2026-PNU-CSE-GRAD-RFVisualizer/Embedded/rssi_esp32_to_stm32/stm32_receiver/README.md

# STM32 Receiver Module

This folder contains board-portable C modules for the STM32 side.

Files:

- `rssi_line_parser.*`: byte stream and line parser for `$RSSI` messages.
- `rssi_preprocessor.*`: node table, timeout tracking, sequence loss tracking.
- `mqtt_payload.*`: MQTT-ready JSON payload formatter.
- `stm32_uart_receiver_example.c`: HAL UART interrupt integration example.
- `test_parser_host.c`: PC host test.

The parser and preprocessor use no dynamic allocation. Packet/UART protocol version 2
preserves the originating node's Unix epoch measurement time in
`readings[].timestamp`; a zero timestamp is invalid and is accompanied by
`RSSI_ERR_TIME_INVALID`.

## Integration Steps

1. Add `rssi_line_parser.c`, `rssi_preprocessor.c`, and `mqtt_payload.c` to the STM32CubeIDE project.
2. Include the corresponding headers.
3. In the UART RX interrupt callback, feed each byte to `rssi_parser_feed_byte()`.
4. On `RSSI_PARSE_OK`, call `rssi_preprocessor_update()`.
5. Periodically call `mqtt_payload_build_snapshot()`, passing monotonic uptime for
   timeout calculations and Unix epoch milliseconds for snapshot creation time,
   then publish the resulting string through the selected MQTT/network module.

The included MQTT formatter only builds the payload string; it does not depend on any MQTT client library.
