2026-PNU-CSE-GRAD-RFVisualizer/Embedded/handheld_jpeg_stream/captured_rfjf_frame.bmp

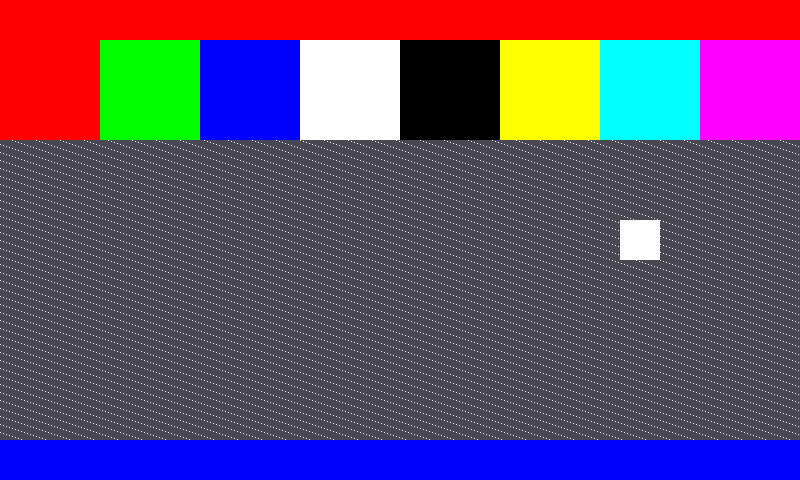
handheld_jpeg_stream/captured_rfjf_frame.bmp
