2026-PNU-CSE-GRAD-RFVisualizer/Embedded/handheld_bno085_test/components/ceva_sh2/VERSION.txt

Upstream: https://github.com/ceva-dsp/sh2
Commit: b514b1e2586ddc195e553dac89fc94c637b25298
License: Apache-2.0 (see NOTICE.txt and source headers)
