2026-PNU-CSE-GRAD-RFVisualizer/Embedded/HANDHELD_BUTTON_WIRING.md

# 폐기됨: Handheld 버튼 단독 배선 문서

이 문서의 이전 버전은 버튼만 대상으로 빨간 선을 신호선으로 지정했으므로 사용하지 않는다.

ESP32-S3, LCD, BNO085, 버튼을 모두 포함하고 전선 색상을 안전하게 통일한 최신 문서는 다음 파일이다.

- [HANDHELD_COMPLETE_WIRING.md](./HANDHELD_COMPLETE_WIRING.md)

최신 기준:

- 검정: GND
- 빨강: 전원(반드시 `5V` 또는 `3V3` 라벨 부착)
- 파랑: 신호(반드시 신호명 라벨 부착)
