2026-PNU-CSE-GRAD-RFVisualizer/Embedded/handheld_jpeg_stream/main/test_animation/frames/frame_03.jpg

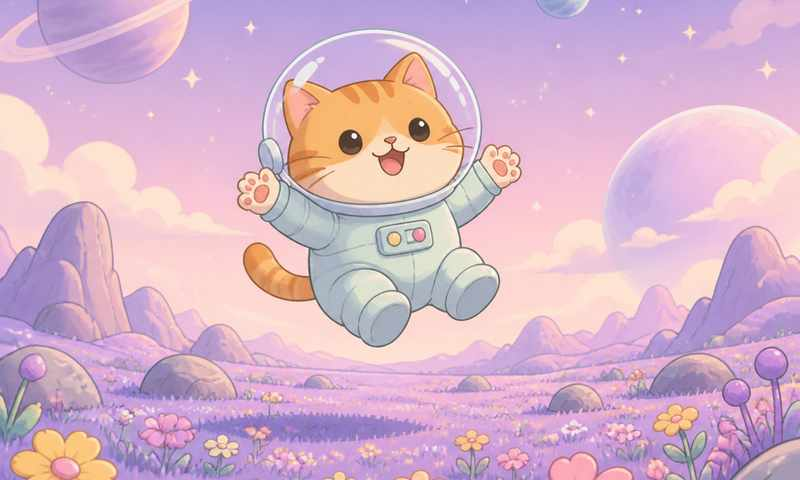
handheld_jpeg_stream/main/test_animation/frames/frame_03.jpg
