2026-PNU-CSE-GRAD-RFVisualizer/Embedded/handheld_jpeg_stream/main/app_main.c

#include <stdbool.h>
#include <string.h>

#include "esp_event.h"
#include "esp_log.h"
#include "esp_timer.h"
#include "esp_netif.h"
#include "esp_wifi.h"
#include "freertos/FreeRTOS.h"
#include "freertos/event_groups.h"
#include "freertos/task.h"
#include "nvs_flash.h"

#include "lcd_board_config.h"
#include "lcd_gpio_writer.h"
#include "jpeg_lcd_sink.h"
#include "jpeg_stream_client.h"
#include "jpeg_stream_protocol.h"
#include "rgb332_zlib_sink.h"
#include "handheld_control_udp.h"
#if CONFIG_HANDHELD_LOCAL_BNO085_LCD_TEST || CONFIG_HANDHELD_CONTROL_UDP || CONFIG_HANDHELD_BNO085_SERVICE
#include "bno085_local_test.h"
#endif
#if CONFIG_HANDHELD_LOCAL_10FPS_TEST
#if CONFIG_HANDHELD_LOCAL_3D_TEST
#include "local_3d_test.h"
#else
#include "local_animation_test.h"
#endif
#endif

#define WIFI_CONNECTED_BIT BIT0

static const char *TAG = "handheld_jpeg";
static EventGroupHandle_t s_wifi_events;

#if 0  /* Disabled: boot RGB test can be confused with server frames. */
static inline uint16_t rgb565(uint8_t red, uint8_t green, uint8_t blue)
{
    return ((uint16_t)(red & 0xF8) << 8) |
           ((uint16_t)(green & 0xFC) << 3) |
           ((uint16_t)blue >> 3);
}

static void show_boot_color_test(void)
{
    static const struct {
        const char *name;
        uint16_t color;
    } colors[] = {
        {"RED",   0xF800},
        {"GREEN", 0x07E0},
        {"BLUE",  0x001F},
    };

    for (size_t i = 0; i < sizeof(colors) / sizeof(colors[0]); ++i) {
        ESP_LOGI(TAG, "boot LCD color test: %s", colors[i].name);
        lcd_gpio_writer_fill(colors[i].color);
        vTaskDelay(pdMS_TO_TICKS(500));
    }

    lcd_gpio_writer_fill(rgb565(0, 0, 0));
    ESP_LOGI(TAG, "boot LCD color test complete");
}
#endif

static void wifi_event_handler(void *argument, esp_event_base_t event_base,
                               int32_t event_id, void *event_data)
{
    (void)argument;
    (void)event_data;
    if (event_base == WIFI_EVENT && event_id == WIFI_EVENT_STA_START) {
        esp_wifi_connect();
    } else if (event_base == WIFI_EVENT && event_id == WIFI_EVENT_STA_DISCONNECTED) {
        xEventGroupClearBits(s_wifi_events, WIFI_CONNECTED_BIT);
        ESP_LOGW(TAG, "Wi-Fi disconnected; reconnecting");
        esp_wifi_connect();
    } else if (event_base == IP_EVENT && event_id == IP_EVENT_STA_GOT_IP) {
        xEventGroupSetBits(s_wifi_events, WIFI_CONNECTED_BIT);
    }
}

static void wifi_start(void)
{
    ESP_ERROR_CHECK(esp_netif_init());
    ESP_ERROR_CHECK(esp_event_loop_create_default());
    esp_netif_create_default_wifi_sta();

    const wifi_init_config_t init_config = WIFI_INIT_CONFIG_DEFAULT();
    ESP_ERROR_CHECK(esp_wifi_init(&init_config));
    ESP_ERROR_CHECK(esp_event_handler_register(WIFI_EVENT, ESP_EVENT_ANY_ID,
                                               wifi_event_handler, NULL));
    ESP_ERROR_CHECK(esp_event_handler_register(IP_EVENT, IP_EVENT_STA_GOT_IP,
                                               wifi_event_handler, NULL));

    wifi_config_t wifi_config = {0};
    strlcpy((char *)wifi_config.sta.ssid, CONFIG_HANDHELD_WIFI_SSID,
            sizeof(wifi_config.sta.ssid));
    strlcpy((char *)wifi_config.sta.password, CONFIG_HANDHELD_WIFI_PASSWORD,
            sizeof(wifi_config.sta.password));
    wifi_config.sta.threshold.authmode = strlen(CONFIG_HANDHELD_WIFI_PASSWORD) > 0
        ? WIFI_AUTH_WPA2_PSK : WIFI_AUTH_OPEN;

    ESP_ERROR_CHECK(esp_wifi_set_mode(WIFI_MODE_STA));
    ESP_ERROR_CHECK(esp_wifi_set_config(WIFI_IF_STA, &wifi_config));
    ESP_ERROR_CHECK(esp_wifi_start());
    /* A DTIM/listen interval of three batches the 10 FPS TCP stream into
     * roughly 300 ms bursts. Keep the Handheld awake for even frame pacing. */
    ESP_ERROR_CHECK(esp_wifi_set_ps(WIFI_PS_NONE));
    ESP_LOGI(TAG, "Wi-Fi power save disabled for low-latency image streaming");
}

static void on_jpeg_frame(const jpeg_stream_frame_t *frame, void *user_context)
{
    (void)user_context;
    static int64_t window_start;
    static uint32_t displayed, failed;
    static jpeg_stream_client_stats_t previous;
    const int64_t started = esp_timer_get_time();
    if (!window_start) window_start = started;
    esp_err_t result;
    if (frame->flags == JPEG_STREAM_FLAG_RGB332_ZLIB ||
        frame->flags == JPEG_STREAM_FLAG_PALETTE256_ZLIB) {
        result = rgb332_zlib_sink_render(frame);
    } else {
        result = jpeg_lcd_sink_render(frame);
    }
    if (result == ESP_OK) ++displayed;
    else ++failed;
    const int64_t now = esp_timer_get_time();
    if (now - window_start >= 1000000) {
        jpeg_stream_client_stats_t current;
        jpeg_stream_client_get_stats(&current);
        const double seconds = (now - window_start) / 1000000.0;
        ESP_LOGI(TAG, "stream rx_fps=%.2f display_fps=%.2f stale=%lu gaps=%lu failed=%lu",
                 (current.frames_received - previous.frames_received) / seconds,
                 displayed / seconds,
                 (unsigned long)(current.stale_frames_dropped - previous.stale_frames_dropped),
                 (unsigned long)(current.sequence_gaps - previous.sequence_gaps),
                 (unsigned long)failed);
        previous = current;
        displayed = failed = 0;
        window_start = now;
    }
    if (result != ESP_OK) {
        ESP_LOGW(TAG, "frame seq=%lu was not displayed: %s",
                 (unsigned long)frame->seq, esp_err_to_name(result));
    }
}

void app_main(void)
{
    esp_err_t nvs_result = nvs_flash_init();
    if (nvs_result == ESP_ERR_NVS_NO_FREE_PAGES ||
        nvs_result == ESP_ERR_NVS_NEW_VERSION_FOUND) {
        ESP_ERROR_CHECK(nvs_flash_erase());
        nvs_result = nvs_flash_init();
    }
    ESP_ERROR_CHECK(nvs_result);

#if CONFIG_HANDHELD_LOCAL_10FPS_TEST || CONFIG_HANDHELD_RGB565_BENCHMARK
    const bool lcd_enabled = true;
#else
    const bool lcd_enabled = CONFIG_JPEG_STREAM_SERVER_HOST[0] != '\0';
#endif
    if (lcd_enabled) {
        ESP_ERROR_CHECK(jpeg_lcd_sink_init());
    } else {
        ESP_LOGI(TAG, "control-only mode: LCD/JPEG buffers are not allocated");
    }
    // show_boot_color_test();  // Disabled while testing server RGB332 frames.

#if CONFIG_HANDHELD_LOCAL_BNO085_LCD_TEST || CONFIG_HANDHELD_CONTROL_UDP || CONFIG_HANDHELD_BNO085_SERVICE
    ESP_ERROR_CHECK(bno085_local_test_start());
    if (lcd_enabled) {
        lcd_gpio_writer_set_transfer_gate(bno085_local_test_lcd_begin,
                                          bno085_local_test_lcd_end);
        ESP_LOGI(TAG, "BNO085 service and LCD I/O gate started");
    } else {
        ESP_LOGI(TAG, "BNO085 service started without LCD I/O");
    }
#endif

#if CONFIG_HANDHELD_RGB565_BENCHMARK
    jpeg_lcd_sink_benchmark();
#endif

#if CONFIG_HANDHELD_LOCAL_10FPS_TEST
    ESP_LOGI(TAG, "local 10 FPS animation test enabled; Wi-Fi is skipped");
#if CONFIG_HANDHELD_LOCAL_3D_TEST
    local_3d_test_run();
#else
    local_animation_test_run();
#endif
#endif

    if (CONFIG_HANDHELD_WIFI_SSID[0] == '\0') {
        ESP_LOGE(TAG, "set Wi-Fi with: idf.py menuconfig");
        return;
    }
#if CONFIG_HANDHELD_CONTROL_UDP
    if (CONFIG_HANDHELD_CONTROL_BACKEND_HOST[0] == '\0') {
        ESP_LOGE(TAG, "set Handheld Control Backend/proxy host with: idf.py menuconfig");
        return;
    }
#else
    if (CONFIG_JPEG_STREAM_SERVER_HOST[0] == '\0') {
        ESP_LOGE(TAG, "set image relay host with: idf.py menuconfig");
        return;
    }
#endif

    s_wifi_events = xEventGroupCreate();
    ESP_ERROR_CHECK(s_wifi_events == NULL ? ESP_ERR_NO_MEM : ESP_OK);
    wifi_start();
    ESP_LOGI(TAG, "waiting for Wi-Fi");
    xEventGroupWaitBits(s_wifi_events, WIFI_CONNECTED_BIT, pdFALSE, pdTRUE,
                        portMAX_DELAY);

#if CONFIG_HANDHELD_CONTROL_UDP
    const handheld_control_udp_config_t control_config = {
        .backend_host = CONFIG_HANDHELD_CONTROL_BACKEND_HOST,
        .backend_port = CONFIG_HANDHELD_CONTROL_BACKEND_PORT,
        .device_id = CONFIG_HANDHELD_CONTROL_DEVICE_ID,
    };
    ESP_ERROR_CHECK(handheld_control_udp_start(&control_config));
    ESP_LOGI(TAG, "Handheld Control UDP started");
#endif

    if (CONFIG_JPEG_STREAM_SERVER_HOST[0] != '\0') {
        const jpeg_stream_client_config_t client_config = {
            .server_host = CONFIG_JPEG_STREAM_SERVER_HOST,
            .server_port = CONFIG_JPEG_STREAM_SERVER_PORT,
            .max_frame_bytes = CONFIG_JPEG_STREAM_MAX_FRAME_BYTES,
            .receive_timeout_ms = CONFIG_JPEG_STREAM_RX_TIMEOUT_MS,
            .reconnect_initial_ms = 1000,
            .reconnect_max_ms = 10000,
            .on_frame = on_jpeg_frame,
            .user_context = NULL,
        };
        ESP_ERROR_CHECK(jpeg_stream_client_start(&client_config));
        ESP_LOGI(TAG, "JPEG stream client started");
    } else {
        ESP_LOGI(TAG, "JPEG stream disabled: no relay host configured");
    }
}
