2026-PNU-CSE-GRAD-RFVisualizer/Embedded/stm32_serial_mqtt_bridge.py

import argparse
import json
import sys
import time
import traceback
from pathlib import Path

from paho.mqtt import MQTTException
import paho.mqtt.client as mqtt

try:
    import serial
except ImportError:
    print("pyserial is required: python -m pip install pyserial")
    raise


DEFAULT_SERVER_IP = "192.168.0.4"
DEFAULT_PORT = 1883
DEFAULT_SERIAL_PORT = "COM4"
DEFAULT_BAUDRATE = 115200
DEFAULT_GATEWAY_ID = "gw-01"
DEFAULT_PUBLISH_MODE = "individual"
DEFAULT_AP_CHANNEL = 6
DEFAULT_POSITIONS_FILE = Path(__file__).with_name("node_positions.json")
SCHEMA_VERSION = 2
RSSI_VALID_MIN_DBM = -110
RSSI_VALID_MAX_DBM = -10
PUBLISH_TIMEOUT_SEC = 5.0
PUBLISH_RETRY_COUNT = 3
RECONNECT_DELAY_SEC = 2.0
HEARTBEAT_INTERVAL_SEC = 2.0


def parse_args():
    parser = argparse.ArgumentParser(
        description="Read STM32 gateway JSON lines from UART and publish them to MQTT."
    )
    parser.add_argument("--server", default=DEFAULT_SERVER_IP)
    parser.add_argument("--port", type=int, default=DEFAULT_PORT)
    parser.add_argument("--serial-port", default=DEFAULT_SERIAL_PORT)
    parser.add_argument("--baudrate", type=int, default=DEFAULT_BAUDRATE)
    parser.add_argument("--gateway-id", default=DEFAULT_GATEWAY_ID)
    parser.add_argument(
        "--ap-channel",
        type=int,
        choices=range(1, 15),
        default=DEFAULT_AP_CHANNEL,
    )
    parser.add_argument("--client-id", default="stm32-serial-gw-01")
    parser.add_argument("--topic", default=None)
    parser.add_argument("--positions-file", default=str(DEFAULT_POSITIONS_FILE))
    parser.add_argument(
        "--publish-mode",
        choices=("individual", "gateway", "both"),
        default=DEFAULT_PUBLISH_MODE,
        help="individual publishes rssi/<node_id>; gateway publishes one batch",
    )
    return parser.parse_args()


def now_ms():
    return int(time.time() * 1000)


def node_name(node_id):
    try:
        numeric = int(node_id)
    except (TypeError, ValueError):
        return str(node_id)

    if numeric == 5:
        return "gw-01"

    return f"node-{numeric:02d}"


def filtered_dbm_from_x10(value):
    value = int(value)
    if value >= 0:
        return int((value + 5) / 10)
    return int((value - 5) / 10)


def publish_checked(client, topic, payload, qos=1, retain=False, retries=PUBLISH_RETRY_COUNT):
    text = json.dumps(payload, separators=(",", ":"))
    last_error = "unknown error"

    for attempt in range(1, retries + 1):
        info = client.publish(topic, text, qos=qos, retain=retain)
        if info.rc != mqtt.MQTT_ERR_SUCCESS:
            last_error = f"rc={info.rc}"
        else:
            try:
                info.wait_for_publish(timeout=PUBLISH_TIMEOUT_SEC)
                if info.is_published():
                    return text
                last_error = f"PUBACK timeout after {PUBLISH_TIMEOUT_SEC:.0f}s"
            except RuntimeError as exc:
                last_error = str(exc)

        if attempt < retries:
            print(f"publish retry {attempt}/{retries} topic={topic}: {last_error}")
            time.sleep(1.0)

    raise RuntimeError(f"publish failed topic={topic}: {last_error}")


def status_payload(gateway_id, online):
    return {
        "node_id": gateway_id,
        "online": online,
        "timestamp": now_ms(),
    }


def load_node_positions(path):
    with open(path, "r", encoding="utf-8") as file:
        raw_positions = json.load(file)

    if not isinstance(raw_positions, dict):
        raise ValueError("positions file must contain a JSON object")

    positions = {}
    for node_id, position in raw_positions.items():
        if not isinstance(position, dict):
            raise ValueError(f"invalid position for {node_id}")

        positions[str(node_id)] = {
            "pos_x": float(position["pos_x"]),
            "pos_y": float(position["pos_y"]),
            "pos_z": float(position["pos_z"]),
        }

    return positions


def attach_position(reading, positions, ap_channel=DEFAULT_AP_CHANNEL):
    node_id = reading["node_id"]
    position = positions.get(node_id)
    positioned = {
        "node_id": node_id,
        "timestamp": reading["timestamp"],
        "rssi": reading["rssi"],
        "seq": reading["seq"],
        "ap_channel": ap_channel,
    }

    if position is not None:
        positioned.update(position)

    if "ap_bssid" in reading:
        positioned["ap_bssid"] = reading["ap_bssid"]
    if "rssi_raw" in reading:
        positioned["rssi_raw"] = reading["rssi_raw"]

    positioned["status"] = reading["status"]
    return positioned, position is not None


def normalize_reading(item, batch_timestamp, require_node_timestamp=False):
    node_id = node_name(item["node_id"])
    timestamp_value = item.get("timestamp", item.get("node_ts"))
    if timestamp_value is None:
        if require_node_timestamp:
            raise ValueError(f"{node_id} reading is missing timestamp")
        timestamp_value = batch_timestamp

    timestamp = int(timestamp_value)
    rssi = int(item["rssi"])
    if not RSSI_VALID_MIN_DBM <= rssi <= RSSI_VALID_MAX_DBM:
        return None

    reading = {
        "node_id": node_id,
        "timestamp": timestamp,
        "rssi": rssi,
        "seq": int(item.get("seq", 0)),
        "status": int(item.get("status", item.get("error_flags", 0))),
    }

    if "rssi_raw" in item:
        reading["rssi_raw"] = int(item["rssi_raw"])
    elif "rssi_raw_dbm" in item:
        reading["rssi_raw"] = int(item["rssi_raw_dbm"])

    if item.get("ap_bssid"):
        reading["ap_bssid"] = str(item["ap_bssid"])

    return reading


def normalize_gateway_payload(raw_payload, gateway_id):
    received_timestamp = now_ms()

    if "readings" in raw_payload:
        schema_version = int(raw_payload.get("schema_version", SCHEMA_VERSION))
        if schema_version != SCHEMA_VERSION:
            raise ValueError(f"unsupported schema_version: {schema_version}")

        timestamp = int(raw_payload.get("timestamp", received_timestamp))
        readings = raw_payload.get("readings") or []
        normalized_readings = []
        for item in readings:
            if "node_id" not in item or "rssi" not in item:
                continue

            reading = normalize_reading(
                item,
                timestamp,
                require_node_timestamp=True,
            )
            if reading is not None:
                normalized_readings.append(reading)

        return {
            "schema_version": SCHEMA_VERSION,
            "gateway_id": raw_payload.get("gateway_id", gateway_id),
            "timestamp": timestamp,
            "readings": normalized_readings,
        }

    # Compatibility with the older STM32 payload:
    # {"device_id":...,"nodes":[{"node_id":5,"rssi_filtered_x10":-598,...}]}
    if "nodes" in raw_payload:
        timestamp = received_timestamp
        readings = []
        for item in raw_payload.get("nodes") or []:
            if "node_id" not in item:
                continue

            if "rssi" in item:
                rssi = int(item["rssi"])
            elif "rssi_filtered_x10" in item:
                rssi = filtered_dbm_from_x10(item["rssi_filtered_x10"])
            else:
                continue

            if not RSSI_VALID_MIN_DBM <= rssi <= RSSI_VALID_MAX_DBM:
                continue

            reading = {
                "node_id": node_name(item["node_id"]),
                "timestamp": timestamp,
                "rssi": rssi,
                "seq": int(item.get("seq", 0)),
                "status": int(item.get("error_flags", item.get("status", 0))),
            }
            if "rssi_raw_dbm" in item:
                reading["rssi_raw"] = int(item["rssi_raw_dbm"])
            for field in ("sample_count", "lost_count", "duplicate_count", "age_ms"):
                if field in item:
                    reading[field] = int(item[field])
            readings.append(reading)

        return {
            "schema_version": SCHEMA_VERSION,
            "gateway_id": gateway_id,
            "timestamp": timestamp,
            "readings": readings,
        }

    raise ValueError("payload has neither readings nor nodes")


def main():
    args = parse_args()
    data_topic = args.topic or f"gateway/{args.gateway_id}"
    status_topic = f"status/{args.gateway_id}/lwt"
    positions_path = Path(args.positions_file)
    if positions_path.is_file():
        try:
            positions = load_node_positions(positions_path)
        except (OSError, KeyError, TypeError, ValueError, json.JSONDecodeError) as exc:
            raise SystemExit(f"positions config error: {exc}") from exc
    else:
        positions = {}
        print(
            f"warning: positions file not found: {positions_path}; "
            "publishing without pos_x/pos_y/pos_z"
        )

    warned_missing_positions = set()
    last_published_seq = {}
    last_heartbeat_at = 0.0

    client = mqtt.Client(mqtt.CallbackAPIVersion.VERSION2, client_id=args.client_id)
    client.reconnect_delay_set(min_delay=1, max_delay=10)
    client.will_set(
        status_topic,
        json.dumps(status_payload(args.gateway_id, online=False), separators=(",", ":")),
        qos=1,
        retain=True,
    )

    def on_connect(connected_client, _userdata, _flags, reason_code, _properties):
        if getattr(reason_code, "is_failure", False):
            print(f"mqtt connection failed: {reason_code}")
            return

        connected_client.publish(
            status_topic,
            json.dumps(status_payload(args.gateway_id, online=True), separators=(",", ":")),
            qos=1,
            retain=True,
        )
        print(f"mqtt connected: client_id={args.client_id}")

    def on_disconnect(_client, _userdata, _disconnect_flags, reason_code, _properties):
        if getattr(reason_code, "is_failure", False):
            print(f"mqtt disconnected unexpectedly: {reason_code}; reconnecting...")

    client.on_connect = on_connect
    client.on_disconnect = on_disconnect

    print(f"opening serial {args.serial_port} @ {args.baudrate} ...")
    with serial.Serial(args.serial_port, args.baudrate, timeout=1) as ser:
        print(f"connecting mqtt {args.server}:{args.port} ...")
        client.connect(args.server, args.port, keepalive=30)
        client.loop_start()

        if args.publish_mode in ("gateway", "both"):
            print(f"gateway batch topic: {data_topic}")
        if args.publish_mode in ("individual", "both"):
            print("individual topics: rssi/<node_id>")

        try:
            while True:
                now = time.monotonic()
                if now - last_heartbeat_at >= HEARTBEAT_INTERVAL_SEC:
                    try:
                        publish_checked(
                            client,
                            status_topic,
                            status_payload(args.gateway_id, online=True),
                            qos=1,
                            retain=True,
                        )
                        last_heartbeat_at = now
                        print(f"heartbeat {status_topic}: online")
                    except RuntimeError as exc:
                        print(f"heartbeat error: {exc}")

                raw = ser.readline()
                if not raw:
                    continue

                line = raw.decode("utf-8", errors="replace").strip()
                if not line:
                    continue

                if not line.startswith("{"):
                    print("skip:", line)
                    continue

                try:
                    raw_payload = json.loads(line)
                    payload = normalize_gateway_payload(raw_payload, args.gateway_id)
                except (json.JSONDecodeError, ValueError, TypeError) as exc:
                    print(f"bad payload: {exc}: {line}")
                    continue

                if not payload["readings"]:
                    print("skip: payload has no valid readings")
                    continue

                positioned_readings = []
                for reading in payload["readings"]:
                    positioned, position_found = attach_position(
                        reading, positions, args.ap_channel
                    )
                    positioned_readings.append(positioned)
                    if not position_found and reading["node_id"] not in warned_missing_positions:
                        warned_missing_positions.add(reading["node_id"])
                        print(
                            f"warning: {reading['node_id']} position missing; "
                            "publishing without pos_x/pos_y/pos_z"
                        )
                payload["readings"] = positioned_readings

                if args.publish_mode in ("gateway", "both"):
                    try:
                        sent = publish_checked(client, data_topic, payload, qos=1)
                        print(f"sent {data_topic}:", sent)
                    except RuntimeError as exc:
                        print(f"publish error: {exc}")

                if args.publish_mode in ("individual", "both"):
                    for reading in payload["readings"]:
                        node_id = reading["node_id"]
                        seq = reading.get("seq")
                        if seq is not None and last_published_seq.get(node_id) == seq:
                            continue

                        topic = f"rssi/{reading['node_id']}"
                        try:
                            sent = publish_checked(client, topic, reading, qos=1)
                        except RuntimeError as exc:
                            print(f"publish error: {exc}")
                            continue

                        if seq is not None:
                            last_published_seq[node_id] = seq
                        print(f"sent {topic}:", sent)
        finally:
            if client.is_connected():
                try:
                    publish_checked(
                        client,
                        status_topic,
                        status_payload(args.gateway_id, online=False),
                        qos=1,
                        retain=True,
                        retries=1,
                    )
                except RuntimeError as exc:
                    print(f"failed to publish offline status: {exc}")
                client.disconnect()
            client.loop_stop()


if __name__ == "__main__":
    while True:
        try:
            main()
        except KeyboardInterrupt:
            print("stopping...")
            sys.exit(0)
        except (serial.SerialException, MQTTException, OSError) as exc:
            print(f"bridge transport error: {exc}")
            traceback.print_exc()
            print(f"retrying bridge in {RECONNECT_DELAY_SEC:.0f}s...")
            time.sleep(RECONNECT_DELAY_SEC)
