2026-PNU-CSE-GRAD-RFVisualizer/Embedded/stm32_final_term/Inc/mqtt_payload.h

#ifndef MQTT_PAYLOAD_H
#define MQTT_PAYLOAD_H

#include <stddef.h>
#include <stdint.h>

#include "rssi_preprocessor.h"

#define MQTT_PAYLOAD_MAX_LEN    1536

int mqtt_payload_build_snapshot(char *out,
                                size_t out_len,
                                const char *gateway_id,
                                const rssi_preprocessor_t *ctx,
                                uint32_t now_uptime_ms,
                                uint64_t snapshot_timestamp_ms);

#endif
