2026-PNU-CSE-GRAD-RFVisualizer/Embedded/handheld_jpeg_stream/main/jpeg_stream_protocol.h

#pragma once

#include <stdbool.h>
#include <stddef.h>
#include <stdint.h>

#define JPEG_STREAM_MAGIC       0x52464A46u /* 'RFJF' */
#define JPEG_STREAM_VERSION     1u
#define JPEG_STREAM_HEADER_SIZE 22u

/* Version 1 keeps the same 22-byte header. The flags byte selects payload
 * encoding so existing JPEG producers remain compatible. */
#define JPEG_STREAM_FLAG_JPEG        0x00u
#define JPEG_STREAM_FLAG_RGB332_ZLIB 0x01u
#define JPEG_STREAM_FLAG_PALETTE256_ZLIB 0x02u

typedef struct {
    uint8_t flags;
    uint32_t seq;
    uint64_t timestamp_ms;
    uint32_t payload_length;
} jpeg_stream_header_t;

typedef enum {
    JPEG_STREAM_HEADER_OK = 0,
    JPEG_STREAM_HEADER_BAD_ARGUMENT,
    JPEG_STREAM_HEADER_BAD_MAGIC,
    JPEG_STREAM_HEADER_BAD_VERSION,
    JPEG_STREAM_HEADER_TOO_LARGE,
} jpeg_stream_header_result_t;

jpeg_stream_header_result_t jpeg_stream_parse_header(
    const uint8_t header[JPEG_STREAM_HEADER_SIZE],
    size_t max_payload_bytes,
    jpeg_stream_header_t *out);

bool jpeg_stream_flag_is_supported(uint8_t flags);
const char *jpeg_stream_header_result_name(jpeg_stream_header_result_t result);
