2026-PNU-CSE-GRAD-RFVisualizer/Embedded/handheld_jpeg_stream/main/lcd_gpio_writer.h

#pragma once

#include <stddef.h>
#include <stdint.h>

#include "esp_err.h"

#ifdef __cplusplus
extern "C" {
#endif

typedef esp_err_t (*lcd_gpio_writer_gate_begin_t)(void);
typedef void (*lcd_gpio_writer_gate_end_t)(void);

/* Initializes the panel with the verified GPIO sequence, then switches frame
 * transfers to the ESP32-S3 16-bit I80 DMA peripheral. */
esp_err_t lcd_gpio_writer_init(void);
void lcd_gpio_writer_set_transfer_gate(
    lcd_gpio_writer_gate_begin_t begin,
    lcd_gpio_writer_gate_end_t end);
void lcd_gpio_writer_fill(uint16_t color);
void lcd_gpio_writer_fill_rect(uint16_t x, uint16_t y, uint16_t width,
                               uint16_t height, uint16_t color);
esp_err_t lcd_gpio_writer_draw(const uint16_t *pixels, size_t pixel_count);
esp_err_t lcd_gpio_writer_draw_rgb332(const uint8_t *pixels,
                                       size_t pixel_count);
esp_err_t lcd_gpio_writer_draw_palette256(const uint8_t *indices,
                                          size_t pixel_count,
                                          const uint8_t *palette_rgb565_be,
                                          size_t palette_bytes);

#ifdef __cplusplus
}
#endif
