2026-PNU-CSE-GRAD-RFVisualizer/Embedded/(commit log)

2026-07-22 26.07.22 stm32 전처리 수정 및 주석
    - stm32에 들어갈 전처리 수정
    - 중심 코드에 주석 추가
    [app_main.c, gateway_config.h, main.c, mqtt_payload.c, mqtt_payload.h, rssi_line_parser.c, rssi_preprocessor.c, rssi_preprocessor.h]
2026-07-23 26.07.23 논문 코드 수정
    왜안되
    [app_main.c, gateway_config.h, gateway_rssi.c, main.c, mqtt_payload.c, mqtt_payload.h, rssi_line_parser.c]
2026-08-05 26.08.05 lcd 예시
    아오 왜 안돼
2026-08-05 아니 왜 안되냐고
2026-08-06 어 뭔가 됐음
2026-08-06 26.08.06 lcd test 최종 확인완료
2026-08-06 26.08.06 이미지 데이터 테스트 완료
2026-08-06 26.08.07 BNO085 9축센서 테스트성공
2026-08-19 26.08.19 lcd 테스트 (미완)
2026-08-19 26.08.19 lcd dma 방식으로 전환 (미완)
2026-08-19 26.08.19 lcd dma 10fps 로컬테스트 완료
2026-08-20 26.08.20 lcd 서버 압축 테스트 완료
2026-08-21 26.08.21 esp32, stm32 빌드 및 플래시 완료
    주석들은 나중에 한번에 정리해봐야할듯 꿹뚫쒧뤫??
2026-08-21 26.08.21 서버 전송 코드 수정 및 노드 위치 설정
    [stm32_serial_mqtt_bridge.py, test_stm32_serial_mqtt_bridge.py]
2026-08-21 26.08.21 클로드가 고치라한 부분 고침
    "명령하지마라"
2026-08-24 26.08.24 핸드헬드 기초
2026-08-24 26.08.25 lcd+BNO 테스트 (1단계 완료)
2026-08-24 26.08.25 3d 시점 이동 테스트 완료
2026-08-25 26.08.25 네트워크 udp 테스트 완료
2026-08-26 26.08.26 lcd 문제 해결(이라 쓰고 정신병 퇴치)
2026-08-27 26.08.27 rgb332에서 팔레트로 변경 (완료)
2026-09-01 26.09.01 버튼 로직 추가 완료
2026-09-09 26.09.10 병목 1차 해결
2026-09-09 26.09.10 병목 및 최적화 (완)
